histind/RTS_Rover/Images/IMG_20121113_195519.jpg

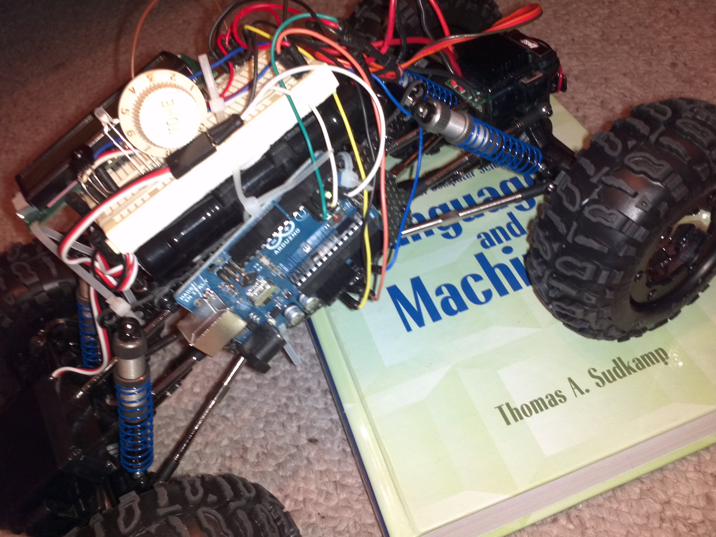
Images/IMG_20121113_195519.jpg
