histind/RTS_Rover/Images/IMG_0900.JPG

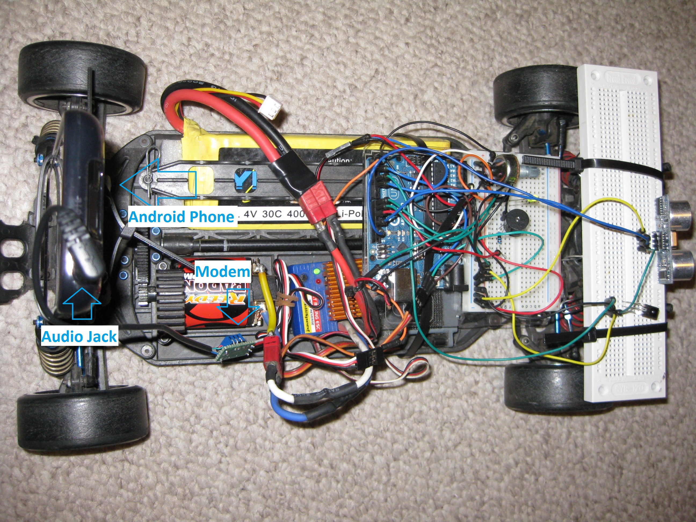
Images/IMG_0900.JPG
