histind/RTS_Rover/README.md

RTS_Rover
=========

An Android/Arduino integrated robotic RC vehicle project
