histind/RTS_Rover/Images/IMG_0902.JPG

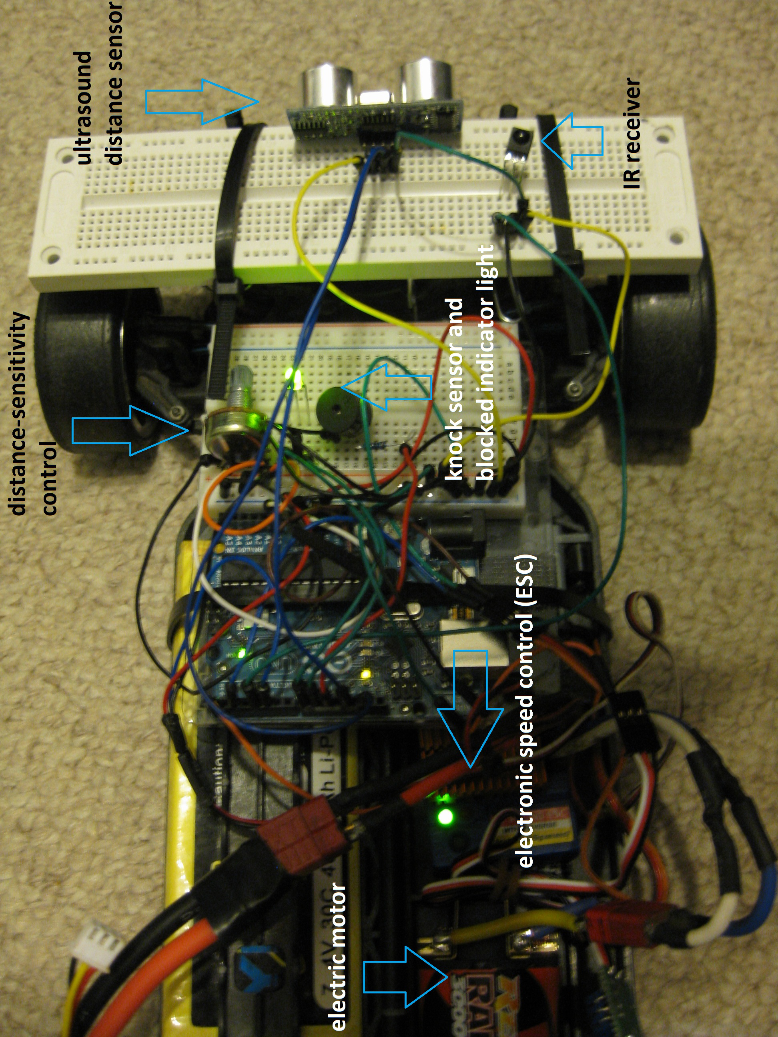
Images/IMG_0902.JPG
