histind/RTS_Rover/Images/IMG_20121113_202037.jpg

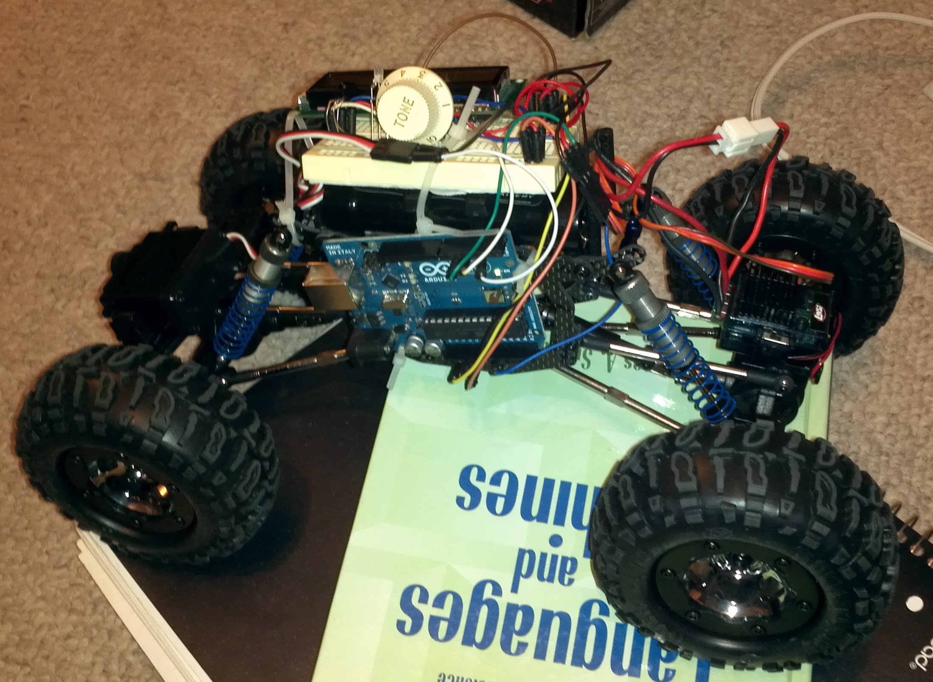
Images/IMG_20121113_202037.jpg
