histind/RTS_Rover/Images/screenshot_audioserialout.png

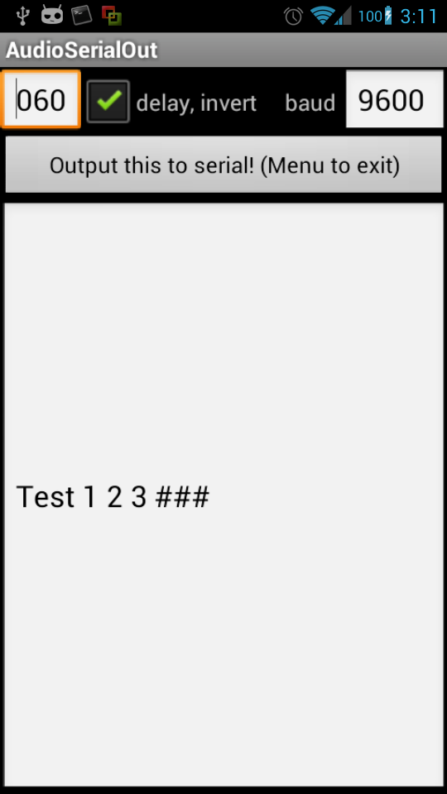
Images/screenshot_audioserialout.png
